dride/dride4K-Manufacturing/README.md

# dride4K-Manufacturing
dride4K-Manufacturing files , mechanical integration files and logistics
