dride/dride4K-Manufacturing/Hardware/BOM/Dride4K_BOM 301122.xlsx

Product SKU List |  |  | PCB List |  |  |  |  |  |  |  |  | Plastic List
front | 1076 |  | GPS HAT A | 1668 |  |  |  |  |  |  |  | 216DRI000 | Dride4K IR Cover | 3398
front + 4G | 621 |  | GPS Spacer | 1668 |  |  |  |  |  |  |  | 216DRI001 | Dride4K light guide | 5760
dual | 269 |  | LTE HAT A | 4332 |  |  |  |  |  |  |  | 216DRI002 | Dride4K Internal camera shell | 3510
dual + 4G | 177 |  | LTE Spacer | 4332 |  |  |  |  |  |  |  | 216DRI003 | Dride4K Camera Body | 5917
front + 128GB | 235 |  | Internal | 3585 |  |  |  |  |  |  |  | 216DRI004 | Dride4K Internal camera cover | 3482
front + 4G + 128 GB | 483 |  | External | 6000 |  |  |  |  |  |  |  | 216DRI005 | Dride4K Screw cover | 11779
Dual + 128GB | 88 |  | Radar | 6000 |  |  |  |  |  |  |  | 216DRI006 | Dride4K Button | 5901
Dual + 4G + 128GB | 3051 |  | Core | 2143 |  |  |  |  |  |  |  | 216DRI007 | Dride4K Braket | 5922
 |  |  | Extended Core | 3857 |  |  |  |  |  |  |  | 216DRI008 | Dride4K Button shell | 5910
LTE Type List |  |  |  |  |  |  |  |  |  |  |  | 216DRI010 | Dride4K Main Body SIM less | 1668
EC25-E | 2084
EC25-AF | 1957
EC25-AU | 219
EG25 | 72
Comment | Description | Footprint | LibRef | Manufacturer | Part Number | GPS HAT A | GPS Spacer | LTE HAT A | LTE Spacer | Internal | External | Radar | Core | Extended Core | front | front + 4G | dual | dual + 4G | front + 128GB | front + 4G + 128 GB | Dual + 128GB | Dual + 4G + 128GB | Total | Price/unit | Total Price
EC25-E | IoT/M2M-optimized LTE Cat4 Module 50Mbps/150Mbps UART/USB2.0/PCM/USIM/SDIO 850MHz/900MHz/1800MHz/1900MHz 3.8V Surface... | IC_XCVR_EC25EFA-512-STD/EC25EFAR02A09M4G | Quectel | EC25EFA-512-STD/EC25EFAR02A09M4G |  |  |  | 1 |  |  |  |  |  |  |  |  |  |  |  |  |  |  | 2084 | $28.9231
EC25-AF |  |  | Quectel |  |  |  |  | 0 |  |  |  |  |  |  |  |  |  |  |  |  |  |  | 1957
EC25-AU |  |  | Quectel |  |  |  |  | 0 |  |  |  |  |  |  |  |  |  |  |  |  |  |  | 219
EG25 |  |  | Quectel |  |  |  |  | 0 |  |  |  |  |  |  |  |  |  |  |  |  |  |  | 72
0402 orange led | Orange 0402 1 x 0.5 mm 120° | SML-LX0402SOC-TR | SML-LX0402SOC-TR | XINGLIGHT | XL-1005UOC |  |  |  |  |  |  |  | 1 | 1 | 1 | 1 | 1 | 1 | 1 | 1 | 1 | 1 | 6000 | $0.1846
0R | R5%_0R0_0402_63mW | R0402 | R_Ω_5%_0R0_0402_63mW |  |  | 4 |  | 5 |  | 0 | 1 | 1 | 16 | 16 | 22 | 23 | 22 | 23 | 22 | 23 | 22 | 23 | 136332 | $0.0002
0Ω 0603 | RES SMD 0 OHM JUMPER 1/10W 0603 Automotive AEC-Q200 | R0603 | R_Ω_1%_0R_0603_100mW |  |  | 1 |  | 1 |  |  |  |  |  |  | 1 | 1 | 1 | 1 | 1 | 1 | 1 | 1 | 6000 | $0.0006
1.0µF | Capacitor, X5R, ±5% | CAP_0402_C1005X04L | C_u_1.0uF_0402_X5R_5% |  |  |  |  |  |  |  |  |  | 3 | 3 | 3 | 3 | 3 | 3 | 3 | 3 | 3 | 3 | 18000 | $0.0023
1.2pF | 1.2pF Capacitor, NP0, ±2% | CAP_0201_C0603X03L_C | C_p_1p2F_0201_NP0_2% |  |  |  |  |  |  |  |  |  | 1 | 1 | 1 | 1 | 1 | 1 | 1 | 1 | 1 | 1 | 6000 | $0.0015
10µH | Chip inductor, IDC,min = 50 mA, ±20% | L_IND_1.6X0.8_C1608X06L | L_u_10µH_0603_20% |  |  |  |  |  |  |  |  |  | 1 | 1 | 1 | 1 | 1 | 1 | 1 | 1 | 1 | 1 | 6000 | $0.0040
100K 0402 | R1%_100k_0402_63mW | R0402 | R_K_100k_0402_63mW_1% |  |  | 7 |  | 10 |  | 0 | 1 |  | 10 | 10 | 18 | 21 | 18 | 21 | 18 | 21 | 18 | 21 | 120996 | $0.0003
100n_100V | C10%_100n_0603_100V_X7R | C0603 | C10%_100n_0603_100V_X7R |  |  | 0 |  |  |  |  |  |  |  |  | 0 | 0 | 0 | 0 | 0 | 0 | 0 | 0 | 0 | $0.0031
100n_16V | C10%_100n_0402_16V_X7R | C0402 | C10%_100n_0402_16V_X7R |  |  | 3 |  | 6 | 1 | 22 | 10 |  | 46 | 46 | 59 | 63 | 81 | 85 | 59 | 63 | 81 | 85 | 450198 | $0.0008
100pF | C20%_100pF_0402_10V | C0402 | C20%_100pF_0402_10V |  |  | 1 |  | 1 |  |  | 1 |  | 1 | 1 | 3 | 3 | 3 | 3 | 3 | 3 | 3 | 3 | 18000 | $0.0011
100R 0402 | R1%_100R_0402_63mW | R0402 | R_Ω_1%_100R_0402_63mW |  |  |  |  |  |  |  |  |  | 2 | 2 | 2 | 2 | 2 | 2 | 2 | 2 | 2 | 2 | 12000 | $0.0005
100uF | 100 µF ±20% 6.3V Ceramic Capacitor X5R 1206 (3216 Metric) | 1206-HIGH |  |  |  |  |  | 2 |  |  |  |  |  |  | 0 | 2 | 0 | 2 | 0 | 2 | 0 | 2 | 8664 | $0.0615
102pF 0402 | C10%_102pF_0402_50V | C0402 |  |  |  |  |  | 0 |  |  |  |  |  |  | 0 | 0 | 0 | 0 | 0 | 0 | 0 | 0 | 0 | $0.0011
104pF | C20%_104pF_0402_10V | C0402 | C20%_104pF_0402_10V |  |  |  |  |  |  |  |  |  | 1 | 1 | 1 | 1 | 1 | 1 | 1 | 1 | 1 | 1 | 6000 | $0.0008
10K 0402 | R1%_10k_0402_63mW | R0402 | R_K_1%_10k_0402_63mW |  |  | 3 |  | 4 |  | 2 |  | 3 | 10 | 10 | 16 | 17 | 18 | 19 | 16 | 17 | 18 | 19 | 107502 | $0.0003
10M 0402 | RES SMD 10M OHM 1% 1/16W 0402Automotive AEC-Q200 | R0402 | R_1%_10M_0402_63mW |  |  |  |  |  |  |  |  |  | 2 | 2 | 2 | 2 | 2 | 2 | 2 | 2 | 2 | 2 | 12000 | $0.0003
10n_50V | C10%_10n_0402_50V_X7R | C0402 | C10%_10n_0402_50V_X7R |  |  |  |  |  |  |  |  | 1 |  |  | 1 | 1 | 1 | 1 | 1 | 1 | 1 | 1 | 6000 | $0.0015
10nf | C10%_10n_0402_16V_X7R | C0402 | C10%_10n_0402_16V_X7R |  |  |  |  |  |  | 1 | 6 |  | 3 | 3 | 9 | 9 | 10 | 10 | 9 | 9 | 10 | 10 | 57585 | $0.0011
10p_50V | C5%_10p_0402_50V_NP0 | C0402 |  |  |  |  |  | 2 |  |  |  |  |  |  | 0 | 2 | 0 | 2 | 0 | 2 | 0 | 2 | 8664 | $0.0011
10u_10V | C20%_10u_0603_10V_X5R | C0603 | C20%_10u_0603_10V_X5R |  |  | 1 |  | 1 |  | 2 | 4 |  | 16 | 16 | 21 | 21 | 23 | 23 | 21 | 21 | 23 | 23 | 133170 | $0.0062
10uF 25V 0603 | CAP CER 10UF 25V X5R 0603 | C0603 |  |  |  | 2 |  | 2 |  |  |  |  |  |  | 2 | 2 | 2 | 2 | 2 | 2 | 2 | 2 | 12000
10u_6V3 | C20%_10u_0402_6V3_X5R | C0402 | C20%_10u_0402_6V3_X5R |  |  | 1 |  | 1 |  | 3 |  | 1 |  |  | 2 | 2 | 5 | 5 | 2 | 2 | 5 | 5 | 22755 | $0.0005
10uH_4020 | SWPA4020S100MT 10±20%V 1.60A | L20%_3u3_2020_5A0 |  | Sunlord | SWPA4020S100MT | 1 |  | 2 |  |  |  |  |  |  | 1 | 2 | 1 | 2 | 1 | 2 | 1 | 2 | 10332 | $0.0277
120R(Z) | FB25%_120R(Z)_0603_3A | 603 |  | FB25%_120R(Z)_0603_3A |  |  |  |  |  |  | 1 |  |  |  | 1 | 1 | 1 | 1 | 1 | 1 | 1 | 1 | 6000 | $0.0015
12pF | 12pF Capacitor, NP0, ±2% | CAP_0201_C0603X03L_C |  | C_p_12pF_V_NP0_2% |  |  |  |  |  |  |  |  | 4 | 4 | 4 | 4 | 4 | 4 | 4 | 4 | 4 | 4 | 24000 | $0.0015
12uH_4020 | SWPA4020S120MT 12±20%V 1.50A | L20%_3u3_2020_5A0 |  | Sunlord | SWPA4020S120MT | 1 |  | 1 |  |  |  |  |  |  | 1 | 1 | 1 | 1 | 1 | 1 | 1 | 1 | 6000 | $0.0277
13K | 13K | R0402 | R_K_13K_0402_63mW_1% |  |  |  |  |  |  | 0 |  |  |  |  | 0 | 0 | 0 | 0 | 0 | 0 | 0 | 0 | 0 | $0.0005
13K6 0402 | RES SMD 13.6K OHM 1% 1/10W 0402 | R0402 | R_K_1%_13K6_0402_0.1W |  |  | 1 |  | 1 |  |  |  |  |  |  | 1 | 1 | 1 | 1 | 1 | 1 | 1 | 1 | 6000 | $0.0005
150k | R1%_150k_0402_63mW | R0402 | R_K_1%_150k_0402_63mW |  |  |  |  |  |  |  |  |  | 1 | 1 | 1 | 1 | 1 | 1 | 1 | 1 | 1 | 1 | 6000 | $0.0005
15nH | High frequency chip inductor ±10% | L_IND_0402_C1005X04L | L_n_15nH_0402_10% |  |  |  |  |  |  |  |  |  | 1 | 1 | 1 | 1 | 1 | 1 | 1 | 1 | 1 | 1 | 6000 | $0.0015
15pF 0402 | CAP CER 15PF 50V C0G/NPO 0402 | C0402 | C5%_15pF_0402_50V |  |  |  |  |  |  |  |  |  | 2 | 2 | 2 | 2 | 2 | 2 | 2 | 2 | 2 | 2 | 12000 | $0.0011
17K65 0402 | RES SMD 17.65K OHM 1% 1/10W 0402 | R0402 |  |  |  |  |  | 1 |  |  |  |  |  |  | 0 | 1 | 0 | 1 | 0 | 1 | 0 | 1 | 4332 | $0.0005
18pF | CAP CER 18PF 50V C0G/NPO 0402 | C0402 | C5%_18pF_0402_50V |  |  |  |  |  |  |  |  |  | 4 | 4 | 4 | 4 | 4 | 4 | 4 | 4 | 4 | 4 | 24000 | $0.0011
1k | R1%_1k0_0402_63mW | R0402 | R_K_1%_1k0_0402_63mW |  |  | 2 |  | 2 |  |  | 6 |  | 3 | 3 | 11 | 11 | 11 | 11 | 11 | 11 | 11 | 11 | 66000 | $0.0003
1K5R 0402 | R1%_1K5R_0402_63mW | R0402 | R_K_1%_1K5R_0402_63mW |  |  |  |  |  |  |  | 2 |  |  |  | 2 | 2 | 2 | 2 | 2 | 2 | 2 | 2 | 12000 | $0.0003
1KR_100Mhz_0402 | 1 kOhms @ 100MHz 1 Signal Line Ferrite Bead 0402 (1005 Metric) 250mA 1.1Ohm BLM15HG102SN1D | C0402 | FB_1KR_100Mhz_0402_1 |  |  |  |  |  |  |  | 2 |  |  |  | 2 | 2 | 2 | 2 | 2 | 2 | 2 | 2 | 12000 | $0.0012
1M 0402 | RES SMD 1M OHM 1% 1/16W 0402 | R0402 | R_1%_1M_0402_63mW |  |  | 3 |  | 3 |  | 1 |  | 2 | 1 | 1 | 6 | 6 | 7 | 7 | 6 | 6 | 7 | 7 | 39585 | $0.0003
1M5R 0402 | RES SMD 1.5M OHM 1% 1/16W 0402 | R0402 | R_M_1M5R_0402_63mW |  |  |  |  |  |  |  |  | 1 |  |  | 1 | 1 | 1 | 1 | 1 | 1 | 1 | 1 | 6000 | $0.0005
1n_16V | C10%_1n_0402_16V_X7R | C0402 | C10%_1n_0402_16V_X7R |  |  |  |  |  |  |  |  |  | 3 | 3 | 3 | 3 | 3 | 3 | 3 | 3 | 3 | 3 | 18000 | $0.0011
1n_50V | C5%_1n_0402_50V_NP0 | C0402 | C5%_1n_0402_50V_NP0 |  |  |  |  |  |  |  | 1 | 4 |  |  | 5 | 5 | 5 | 5 | 5 | 5 | 5 | 5 | 30000 | $0.0011
1N5819 | 1N5819 | SOD123H14A | DIODE_SCHOTTKY | Jingdao Microelectronics | 1N5819 |  |  |  |  |  |  |  | 1 | 1 | 1 | 1 | 1 | 1 | 1 | 1 | 1 | 1 | 6000 | $0.0123
1pF | 1pF Capacitor, NP0, ±2% | CAP_0201_C0603X03L_C | C_p_1p0F_0201_NP0_2% |  |  |  |  |  |  |  |  |  | 1 | 1 | 1 | 1 | 1 | 1 | 1 | 1 | 1 | 1 | 6000 | $0.0015
1u_10V | C10%_1u_0402_10V_X5R | C0402 | C10%_1u_0402_10V_X5R |  |  | 2 | 1 | 2 |  | 4 | 2 | 2 | 7 | 7 | 14 | 13 | 18 | 17 | 14 | 13 | 18 | 17 | 94008 | $0.0023
1uH_2A | SMD INDUCTOR NR252012-1R0MC 1.0uH±20% DCR0.052-2.4A L2520 | L_1.0uH±20%_2.4A_L2520 | L_1uH_2.4A_20% | Sunlord | SWPA252012S 1R0 |  |  |  |  |  |  |  | 4 | 4 | 4 | 4 | 4 | 4 | 4 | 4 | 4 | 4 | 24000 | $0.0231
1W IR LED | 1W IR LED | IR_LED | D_IR_LED_1W | Guangzhou Juhong Optoelectronics | JH-1IRZ14G30-T3A-M850 |  |  |  |  | 1 |  |  |  |  | 0 | 0 | 1 | 1 | 0 | 0 | 1 | 1 | 3585 | $0.2308
2.2nH | 2.2nH High frequency chip inductor ±5% | L_IND_0201_C0603X03L_C | L_n_2n2H_0201_5% |  |  |  |  |  |  |  |  |  | 1 | 1 | 1 | 1 | 1 | 1 | 1 | 1 | 1 | 1 | 6000 | $0.0015
2.2uH@1A | SMD INDUCTOR NR252012-1R0MC 2.2uH±20% DCR0.052-2.4A L2520 | L2520 | L-L2520 | Sunlord | SWPA252010S 2R2 |  |  |  |  |  |  |  | 1 | 1 | 1 | 1 | 1 | 1 | 1 | 1 | 1 | 1 | 6000 | $0.0231
200K 0402 | RES SMD 200K OHM 1% 1/16W 0402 Automotive AEC-Q200 | R0402 | R_K_1%_200K_0402 |  |  |  |  |  |  |  |  |  | 1 | 1 | 1 | 1 | 1 | 1 | 1 | 1 | 1 | 1 | 6000 | $0.0005
20k | R1%_20k_0402_63mW | R0402 | R_K_1%_20K_0402_63mW |  |  |  |  |  |  |  |  | 1 |  |  | 1 | 1 | 1 | 1 | 1 | 1 | 1 | 1 | 6000 | $0.0005
220nF 0402 | C10%_220nF_0402_16V_X7R Ceramic Capacitor | C0402 | C10%_220nF_0402_16V_X7R |  |  |  |  |  |  |  |  |  | 1 | 1 | 1 | 1 | 1 | 1 | 1 | 1 | 1 | 1 | 6000 | $0.0011
22k | R1%_22k_0402_63mW | R0402 | R_K_1%_22K_0402_63mW |  |  |  |  |  |  |  |  | 1 |  |  | 1 | 1 | 1 | 1 | 1 | 1 | 1 | 1 | 6000 | $0.0005
22k6R 0402 | RES SMD 22.6K OHM 1% 1/16W 0402 | R0402 | R_K_22k6R_0402_63mW_1% |  |  | 1 |  | 1 |  |  |  |  |  |  | 1 | 1 | 1 | 1 | 1 | 1 | 1 | 1 | 6000 | $0.0005
22p_50V | C5%_22p_0402_50V_NP0 | C0402 | C5%_22p_0402_16V_NP0 |  |  |  |  |  |  |  |  |  | 1 | 1 | 1 | 1 | 1 | 1 | 1 | 1 | 1 | 1 | 6000 | $0.0011
22pF 0402 | CAP CER 22PF 50V NPO 0402 | C0402 | C5%_22pF_0402_50V |  |  | 2 |  | 3 |  |  |  |  |  |  | 2 | 3 | 2 | 3 | 2 | 3 | 2 | 3 | 16332 | $0.0011
22R | R1%_22R_0402_63mW | R0402 | R_Ω_1%_22R_0402_63mW |  |  | 1 |  | 1 |  |  |  |  | 1 | 1 | 2 | 2 | 2 | 2 | 2 | 2 | 2 | 2 | 12000 | $0.0003
22u_6V3 | C20%_22u_0402_6V3_X5R | C0402 | C20%_22u_0402_6V3_X5R |  |  | 2 |  | 3 |  |  |  |  |  |  | 2 | 3 | 2 | 3 | 2 | 3 | 2 | 3 | 16332 | $0.0308
22uF | C20%_22uF_0603_6v3 | C0603 | C20%_22uF_0603_6v3 |  |  |  |  |  |  |  | 1 |  | 5 | 5 | 6 | 6 | 6 | 6 | 6 | 6 | 6 | 6 | 36000 | $0.0123
22uF_0805 | C20%_22uF_0805_10V_X5R | C0805 | C20%_22uF_0805_10V_X5R |  |  | 1 |  | 1 |  |  |  |  |  |  | 1 | 1 | 1 | 1 | 1 | 1 | 1 | 1 | 6000 | $0.0123
240Ω 0402 | RES SMD 240 OHM 1% 1/16W 0402 Automotive AEC-Q200 | R0402 | R_Ω_1%_240R_0402_63mW |  |  |  |  |  |  |  |  |  | 5 | 5 | 5 | 5 | 5 | 5 | 5 | 5 | 5 | 5 | 30000 | $0.0003
2450AT18A100E | Ceramic Antenna, 2.45 GHZ, 2 W, -40 to 125 degC, 2-Pin SMD, RoHS, Tape and Reel | JT-2450AT18A100-2_V | CMP-2000-05167-1 | Johanson Technology | JT-2450AT18A100-2_V | 1 |  |  |  |  |  |  | 1 | 1 | 2 | 1 | 2 | 1 | 2 | 1 | 2 | 1 | 7668 | $0.1385
24M-20pF-10PPM | 24M-20pF-10PPM | CRYSTAL-4P-3225-H1A | CRY-24MHz-3225-SMD_2 |  |  |  |  |  |  |  |  |  | 1 | 1 | 1 | 1 | 1 | 1 | 1 | 1 | 1 | 1 | 6000 | $0.0769
2K 0402 | RES SMD 2K OHM 1% 1/16W 0402 Automotive AEC-Q200 | R0402 | R_K_1%_2K_0402_63mW |  |  |  |  |  |  |  |  |  | 8 | 8 | 8 | 8 | 8 | 8 | 8 | 8 | 8 | 8 | 48000 | $0.0003
2n2F 0402 | 2200 pF ±5% 50V Ceramic Capacitor X7R 0402 (1005 Metric) | C0402 | C5%_2200pF_2n2F_00402_50V_X7R |  |  |  |  |  |  |  |  |  | 1 | 1 | 1 | 1 | 1 | 1 | 1 | 1 | 1 | 1 | 6000 | $0.0011
2R2Ω 0603 | RES SMD 2.2 OHM 1% 1/10W 0603 Automotive AEC-Q200 | R0603 | R_Ω_1%_2R2_0603 |  |  | 1 |  | 1 |  |  |  |  |  |  | 1 | 1 | 1 | 1 | 1 | 1 | 1 | 1 | 6000 | $0.0006
2u2F | C20%_2u2F_0402_6v3 | C0402 | C20%_2u2F_0402_6v3 |  |  |  |  |  |  | 4 |  | 1 | 29 | 29 | 30 | 30 | 34 | 34 | 30 | 30 | 34 | 34 | 194340 | $0.0023
3.3F/2.7V | BCS2R7S335YS0802 | SCAP2-PT3_5-8X25H8A | CAPACITOR_POL | EDLCON | BCS2R7S335YS0802 | 2 |  | 2 |  |  |  |  |  |  | 2 | 2 | 2 | 2 | 2 | 2 | 2 | 2 | 12000 | $0.2308
3.3uH@0.7A DCR<0.1R | 3.3uH@0.7A DCR<0.1R | L3518 | INDUCTOR_Dup2 |  |  |  |  |  |  |  |  |  | 1 | 1 | 1 | 1 | 1 | 1 | 1 | 1 | 1 | 1 | 6000 | $0.0277
300R_100M_0402 | 300R_100M_0402 | 402 | FB_300R_100M_0402 |  |  |  |  |  |  |  |  |  | 2 | 2 | 2 | 2 | 2 | 2 | 2 | 2 | 2 | 2 | 12000 | $0.0025
30K 0402 | RES SMD 30K OHM 1% 1/16W 0402 | R0402 | R_K_1%_30K_0402_63mW |  |  |  |  |  |  |  | 2 |  |  |  | 2 | 2 | 2 | 2 | 2 | 2 | 2 | 2 | 12000 | $0.0003
32.000MHZ | 32 MHz ±20ppm Crystal 8pF 200 Ohms 4-SMD, No Lead | Crystal_32MHz_DFN160X120X45-4N | Y_ABM12-32.000MHZ-B2X-T3 | Abracon | ABM12-32.000MHZ-B2X-T3 |  |  |  |  |  |  |  | 1 | 1 | 1 | 1 | 1 | 1 | 1 | 1 | 1 | 1 | 6000 | $0.6154
32.768KHz | 32.768KHz | CRYSTAL-2P-3215-H0_85A | CRYSTAL2_0 | Abracon | ABS06-32.768KHZ-9-1-T |  |  |  |  |  |  |  | 1 | 1 | 1 | 1 | 1 | 1 | 1 | 1 | 1 | 1 | 6000 | $0.2231
32.768kHz | 32.768kHz Â±10ppm Crystal 9pF 90 kOhms 2-SMD, No Lead | XTAL_ABS06-32.768KHZ-9-1-T | ABS06-32.768KHZ-9-1-T | Abracon | ABS06-32.768KHZ-9-1-T |  |  |  |  |  |  |  | 1 | 1 | 1 | 1 | 1 | 1 | 1 | 1 | 1 | 1 | 6000 | $0.6154
330R | RES SMD 330 OHM 1% 1/10W 0402 | R0402 | R_Ω_1%_330R_0402_1/10W |  |  |  |  |  |  |  |  |  | 4 | 4 | 4 | 4 | 4 | 4 | 4 | 4 | 4 | 4 | 24000 | $0.0003
33pF 0402 | CAP 5% CER 33PF 50V NPO 0402 | C0402 | C5%_33pF_0402_50V |  |  |  |  | 5 | 3 |  | 2 |  |  |  | 2 | 10 | 2 | 10 | 2 | 10 | 2 | 10 | 46656 | $0.0011
33R | R1%_33R_0402_63mW | R0402 | R_Ω_33R_0402_63mW_1%, R_Ω_1%_33R_0402_63mW |  |  | 3 |  | 1 |  |  |  |  | 5 | 5 | 8 | 6 | 8 | 6 | 8 | 6 | 8 | 6 | 39336 | $0.0003
37.4M-16pF-10PPM |  | CRYSTAL-4P-3225-H1A | CRYSTAL-4_0 |  |  |  |  |  |  |  |  |  | 1 | 1 | 1 | 1 | 1 | 1 | 1 | 1 | 1 | 1 | 6000 | $0.0769
3A | F_F_3A_1206_P | 1206 | F_F_3A_1206_P |  |  | 1 |  | 1 |  |  |  |  |  |  | 1 | 1 | 1 | 1 | 1 | 1 | 1 | 1 | 6000 | $0.0462
4.7nH | 4.7nH High frequency chip inductor ±5% | L_IND_0201_C0603X03L_C | L_n_4n7H_0201_5% |  |  |  |  |  |  |  |  |  | 1 | 1 | 1 | 1 | 1 | 1 | 1 | 1 | 1 | 1 | 6000 | $0.0015
470nF | C10%_470n_0402_16V_X5R | C0402 | C10%_470n_0402_16V_X5R |  |  |  |  |  |  |  |  |  | 3 | 3 | 3 | 3 | 3 | 3 | 3 | 3 | 3 | 3 | 18000 | $0.0011
470R | 470R | R0402 | R_Ω_470R_0402_63mW_1% |  |  | 1 |  |  |  |  |  |  |  |  | 1 | 0 | 1 | 0 | 1 | 0 | 1 | 0 | 1668 | $0.0006
473pF | C10%_473pF_0402_6v3 | C0402 | C10%_473pF_0402_6v3 |  |  |  |  |  |  | 0 |  |  |  |  | 0 | 0 | 0 | 0 | 0 | 0 | 0 | 0 | 0 | $0.0011
47K 0402 | RES SMD 47K OHM 1% 1/16W 0402 Automotive AEC-Q200 | R0402 | R_K_47K_0402_1% |  |  |  |  |  |  |  |  | 1 | 1 | 1 | 2 | 2 | 2 | 2 | 2 | 2 | 2 | 2 | 12000 | $0.0003
47nF | 47nF | C0402 | C10%_47n_0402_16V_X7R |  |  |  |  |  |  | 1 | 2 |  | 1 | 1 | 3 | 3 | 4 | 4 | 3 | 3 | 4 | 4 | 21585 | $0.0011
4k7 | R1%_4k7_0402_63mW | R0402 | R_K_1%_4k7_0402_63mW |  |  |  |  |  |  | 2 |  |  |  |  | 0 | 0 | 2 | 2 | 0 | 0 | 2 | 2 | 7170 | $0.0005
4p7F 0402 | CAP CER 4.7PF 50V C0G/NPO 0402 | C0402 | C5%_4p7F_0402_50V |  |  |  |  |  |  |  |  |  | 1 | 1 | 1 | 1 | 1 | 1 | 1 | 1 | 1 | 1 | 6000 | $0.0011
4pF_0402 | C_p_4pF_0402_25V_C0G/NP0_+-0.25pF | C0402 | C_p_4pF_0402_25V_C0G/NP0_+-0.25pF |  |  |  |  |  |  |  |  | 1 |  |  | 1 | 1 | 1 | 1 | 1 | 1 | 1 | 1 | 6000 | $0.0011
4u7F | C20%_4u7F_0402_6v3, [NoValue] | C0402 | C20%_4u7F_0402_6v3, C20%_4u7_0402_6.3V_X5R |  |  |  |  |  |  | 5 | 16 |  | 7 | 7 | 23 | 23 | 28 | 28 | 23 | 23 | 28 | 28 | 155925 | $0.0031
4u7F 0603 | C20%_4u7F_0603_10V | C0603 | C20%_4u7F_0603_10V |  |  |  |  |  |  |  |  |  | 4 | 4 | 4 | 4 | 4 | 4 | 4 | 4 | 4 | 4 | 24000 | $0.0042
4u7F 0603 25V | CAP CER 4.7UF 25V X5R 0603 | C0603 | C20%_4u7F_0603_25V |  |  | 2 |  | 3 |  |  |  |  |  |  | 2 | 3 | 2 | 3 | 2 | 3 | 2 | 3 | 16332 | $0.0046
5.1K | R_K_5K1_0402_1%_63mW | R0402 | R_K_5K1_0402_1%_63mW |  |  | 2 |  | 2 |  |  |  |  |  |  | 2 | 2 | 2 | 2 | 2 | 2 | 2 | 2 | 12000 | $0.0003
500R@100MHz | Murata DLW5BTN501SQ2L | L25%_500R@100MHz_4A_Common_Mode_Choke | L25%_500R@100MHz_4A_Common_Mode_Choke | Murata | DLW5BTM501SQ2L | 1 |  | 1 |  |  |  |  |  |  | 1 | 1 | 1 | 1 | 1 | 1 | 1 | 1 | 6000 | $0.4462
51k | R1%_51k_0603_100mW | R0603 |  |  |  |  |  | 1 |  |  |  |  |  |  | 0 | 1 | 0 | 1 | 0 | 1 | 0 | 1 | 4332 | $0.0006
51K 0402 | RES SMD 51K OHM 1% 1/16W 0402 Automotive AEC-Q200 | R0402 | R_K_1%_51K_0402_63mW |  |  |  |  |  |  |  |  |  | 2 | 2 | 2 | 2 | 2 | 2 | 2 | 2 | 2 | 2 | 12000 | $0.0003
680R | R1%_680R_0402_63mW | R0402 | R_Ω_1%_680R_0402_63mW |  |  |  |  |  |  |  |  | 0 |  |  | 0 | 0 | 0 | 0 | 0 | 0 | 0 | 0 | 0 | $0.0005
820pF | 820pF Capacitor, NP0, ±2% | CAP_0201_C0603X03L_C | C_p_820pF_0201_NP0_2% |  |  |  |  |  |  |  |  |  | 1 | 1 | 1 | 1 | 1 | 1 | 1 | 1 | 1 | 1 | 6000 | $0.0015
8k2R 0402 | R_K_1%_8k2R_0402_63mW | R0402 | R_K_1%_8k2R_0402_63mW |  |  |  |  |  |  |  |  |  | 1 | 1 | 1 | 1 | 1 | 1 | 1 | 1 | 1 | 1 | 6000 | $0.0005
AP6256 | The AMPAK Technology® AP6256 is a fully Wi-Fi and Bluetooth functionalities module with seamless roaming capabilities and advance security, also it could interact with different vendors’ 802.11a/b/g/n/ac 1x1 Access Points with SISO standard and can accomplish up to speed of 433.3Mbps with single stream in 802.11ac to connect the wireless LAN. | AP6256_QFN44-12X12H1_6A | IC_AP6256 | AMPAK Technology | AP6256 |  |  |  |  |  |  |  | 1 | 1 | 1 | 1 | 1 | 1 | 1 | 1 | 1 | 1 | 6000 | $5.8462
AXP2101 | Power Management IC | AXP_2101_QFN40-PT0_4-5X5H0_8A | IC_AXP2101_0 | Allwinner | AXP_2101 |  |  |  |  |  |  |  | 1 | 1 | 1 | 1 | 1 | 1 | 1 | 1 | 1 | 1 | 6000 | $0.0000
BISS0001 | Micro Power PIR Motion Detector IC | BISS0001 | IC_BISS0001 | Silvan Chip Electronics Tech |  |  |  |  |  |  |  | 1 |  |  | 1 | 1 | 1 | 1 | 1 | 1 | 1 | 1 | 6000 | $0.0538
BLM1.5AG121SN1 | BLM1.5AG121SN1 | 402 | BLM1.5AG121SN1 |  |  | 1 |  |  |  |  |  |  |  |  | 1 | 0 | 1 | 0 | 1 | 0 | 1 | 0 | 1668 | $0.0031
BPW17N | BPW17N | XDCR_BPW17N | BPW17N | Vishay | BPW17N |  |  |  |  | 1 |  |  |  |  | 0 | 0 | 1 | 1 | 0 | 0 | 1 | 1 | 3585 | $0.2769
CMEJ-0415-42-P | CMEJ-0415-42-P | MIC_CMEJ_0415_42_P_SIDE | MIC_CMEJ-0415-42-P | CUI Devices | CMEJ-0415-42-P |  |  |  |  |  | 1 |  |  |  | 1 | 1 | 1 | 1 | 1 | 1 | 1 | 1 | 6000 | $0.2462
CS8302 | CHIP IC MSOP-8 ROHS | MSOP-8_TSSOP-8_SOT505-2 | IC_CS8302 | ICST | ICS8302-01 |  |  |  |  |  | 1 |  |  |  | 1 | 1 | 1 | 1 | 1 | 1 | 1 | 1 | 6000 | $0.2769
D_1615-T0.6 BGR | RGB LED model:XL-1615RGB-RF Name: 1615-T0.6 BGR | LED-1_6X1_5H0_6A | LED_XL-1615RGB-RF | XINGLIGHT | 'XL-1615RGB-RF |  |  |  |  |  |  |  | 1 | 1 | 1 | 1 | 1 | 1 | 1 | 1 | 1 | 1 | 6000 | $0.0092
DA380 | MEMS digital output motion sensor low-power high performance 3-axes “DSC-XYZ” accelerometer | LGA-10_SOP10-PT05-MMA7660FC-H1A | IC_DA380 | MiraMEMS | G-SENSOR DA380B6 LGA10 |  |  |  |  |  |  |  | 1 | 1 | 1 | 1 | 1 | 1 | 1 | 1 | 1 | 1 | 6000 | $0.3538
DDR3-FBGA96 | Commercial Grade : 0℃~95℃ . DDR3(L) 2Gb SDRAM | DDR3_FBGA96C80P10X13 | IC_DDR3-FBGA96_SNB6416S16NS23 | Nanya | NT5CC128M16JR-EK |  |  |  |  |  |  |  | 2 | 2 | 2 | 2 | 2 | 2 | 2 | 2 | 2 | 2 | 12000 | $1.7846
DTC114EE | BJT, NPN, Single, 50V, 0.1A, wb, SC-70, 47K | SOT-416H1_15A | BJT_NPN_wr_x1_0 | ROHM | DTC114EE | 2 |  | 3 |  |  |  |  | 3 | 3 | 5 | 6 | 5 | 6 | 5 | 6 | 5 | 6 | 34332 | $0.0538
ESD | GG0402050R3C2P | C0402 | ESD9B5VL, 1_1.5KE100A_Dup3 | Kyocera AVX | GG0402050R3C2P | 8 |  | 8 |  | 0 | 4 |  | 1 | 1 | 13 | 13 | 13 | 13 | 13 | 13 | 13 | 13 | 78000 | $0.0123
ESD_12V | Diode TVS Single Bi-Directional 12V 130W 0402 2-Pin Surface Mount T/R | C0402 | GG0402126R042P | Kyocera AVX | GG0402126R042P | 1 |  | 1 |  |  |  |  |  |  | 1 | 1 | 1 | 1 | 1 | 1 | 1 | 1 | 6000 | $0.0462
ETST00327000JE | ETST00327000JE | CRYSTAL-2P-3215-H0_85A | CRYSTAL_XCOL-3_0 | HOSONIC | ETST00327000JE |  |  |  |  |  |  |  | 1 | 1 | 1 | 1 | 1 | 1 | 1 | 1 | 1 | 1 | 6000 | $0.2231
FH35C-41S-0.3SHW(99) | FFC FPC Connectors Horizontal Mounting Angle Gray 0.3 mm - Pitch 41 Positions | FH35C-41S-0.3SHW(99) | FH35C-41S-0.3SHW(99) | hirose | FH35C-41S-0.3SHW(99) |  |  |  |  | 1 | 1 |  | 2 | 2 | 3 | 3 | 4 | 4 | 3 | 3 | 4 | 4 | 21585 | $0.2308
FSUSB30UMX | FSUSB30 Series DPDT 4.3 V 480 Mbps SMT Hi Speed USB 2.0 Switch - MSOP-10 | UMLP-10 | FSUSB30UMX | ON Semiconductor | FSUSB30UMX |  |  |  |  |  |  |  | 1 | 1 | 1 | 1 | 1 | 1 | 1 | 1 | 1 | 1 | 6000 | $0.2923
GPIO KEY/UBOOT | GPIO KEY/UBOOT | SW4-SKQG-5_2X5_2H1_5A | SW_PUSH_0 |  |  |  |  |  |  |  |  |  | 1 | 1 | 1 | 1 | 1 | 1 | 1 | 1 | 1 | 1 | 6000 | $0.0123
GPS_ANT | 1575MHz GPS Ultra-Compact Ceramic Chip Antenna | ANT_GPS-1575AT44A0010 | ANT_GPS_1575AT44A0010 | Johanson Technology |  | 0 |  | 0 |  |  |  |  |  |  | 0 | 0 | 0 | 0 | 0 | 0 | 0 | 0 | 0 | $1.0000
HXQK-TYPE-C-3.1 | CQ-USB-C16PSMT01 | USB_TYPEC_7_6X8_94H3_26A | USB_MINI_SOCKET_3 | nova microwave | CQ-USB-C16PSMT01 | 1 |  | 1 |  |  |  |  |  |  | 1 | 1 | 1 | 1 | 1 | 1 | 1 | 1 | 6000 | $0.0092
IMX415 | Sony image sensor IMX415 | IMX415_&_lens_&_mount | IC_IMX415 | SONY | IMX415-AAQR-C |  |  |  |  |  | 1 |  |  |  | 1 | 1 | 1 | 1 | 1 | 1 | 1 | 1 | 6000 | $6.6923
JAE_NANOSIM_SF72S006VBAR2500 | SF72 series, nano-SIM card connector, normail open type, 6 connector | X1 | X_JAE_NANOSIM_SF72S006VBAR2500 | X_JAE_NANOSIM_SF72S006VBAR2500 |  |  |  |  | 1 |  |  |  |  |  | 0 | 1 | 0 | 1 | 0 | 1 | 0 | 1 | 4332 | $0.4615
KLM4G1FETE-B041 | 4 GB eMMC Ver5.1 compatible . HS400- 153FBGA | EMMC_BGA153FBGA | MCP-153FBGA | Samsung Semiconductor | KLM4G1FETE-B041 |  |  |  |  |  |  |  | 1 | 0 | 1 | 1 | 1 | 1 | 0 | 0 | 0 | 0 | 2143 | $2.2308
KLMDG4UCTA-B041 | 128 GB eMMC Ver5.1 compatible | EMMC_BGA169-PT0_5-12X16H1A | MCP-BGA169_5 | Samsung Semiconductor | KLMDG4UCTA-B041 |  |  |  |  |  |  |  | 0 | 1 |  |  |  |  | 1 | 1 | 1 | 1 | 3857 | $18.4615
LP3220SAB5F | LP3220S is a 1.5MHz constant frequency current mode PWM step-down converter | SOT23-5 | IC_LP3220SAB5F | LPSemi | LP3220SAB5F |  |  |  |  |  |  |  | 1 | 1 | 1 | 1 | 1 | 1 | 1 | 1 | 1 | 1 | 6000 | $0.0769
ME6216A12 | ME6216A12XG voltage regulator | ME-6216_SOT23-3 | IC_ME6216A12XG | microne | ME6216A12 |  |  |  |  | 1 |  |  |  |  | 0 | 0 | 1 | 1 | 0 | 0 | 1 | 1 | 3585 | $0.0308
MIC5219BM5 | MIC5219BM5 | IC_MIC5219BM5_SOT23-5 | IC_MIC5219BM5 |  |  |  |  |  |  | 0 |  |  |  |  | 0 | 0 | 0 | 0 | 0 | 0 | 0 | 0 | 0 | $0.9231
MICROSD/TF_SLOT | MICROSD/TF_SLOT | TF_CARDH1_7A | SDMMC SLOT_0 | XKB Connectivity |  |  | 1 |  | 1 |  |  |  |  |  | 1 | 1 | 1 | 1 | 1 | 1 | 1 | 1 | 6000 | $0.0769
ML621 | ML621 | CSE | BAT_6 | FDK | ML621 | 2 |  | 1 |  |  |  |  |  |  | 2 | 1 | 2 | 1 | 2 | 1 | 2 | 1 | 7668 | $0.3231
MX6208 | MX6208 Motor driver power supply voltage range:4.5V-15V 100mAContinuous current SOP8 | MX6208 | IC_MX6208 | Mixic | MX6208 |  |  |  |  | 1 |  |  |  |  | 0 | 0 | 1 | 1 | 0 | 0 | 1 | 1 | 3585 | $0.0338
nRF52833_QFN40 | Multi-protocol Bluetooth Low Energy, IEEE 802.15.4, ANT and 2.4GHz proprietary system-on-chip | QFN40P500X500X50_HS-41N | IC_nRF52833_QDAA | Nordic Semiconductor | nRF52833-QDAA |  |  |  |  |  |  |  | 1 | 1 | 1 | 1 | 1 | 1 | 1 | 1 | 1 | 1 | 6000 | $2.3846
PCF8563 | The PCF8563 is a CMOS1 Real-Time Clock (RTC) and calendar | MSOP-8_TSSOP-8_SOT505-2 | IC_PCF8563 | NXP Semiconductors | PCF8563 |  |  |  |  |  |  |  | 1 | 1 | 1 | 1 | 1 | 1 | 1 | 1 | 1 | 1 | 6000 | $0.5077
RB520S30 | RB520S30 Schottky Barrier Diode SOD-532 Average rectified forward current 200mA Peak forward surge current 1A | SOD-523 | D_SCHOTTKY_RB520S30 | WillSemi | RB520S30 | 1 |  | 1 |  |  |  |  | 2 | 2 | 3 | 3 | 3 | 3 | 3 | 3 | 3 | 3 | 18000 | $0.0154
RB521C30 | Schottky Barrier Diode/SCHOTTKY BARRIER DIODE 200MA | D0402 | DIODE SCHOTTKY | WillSemi | RB521C30 | 1 |  | 1 |  |  |  |  |  |  | 1 | 1 | 1 | 1 | 1 | 1 | 1 | 1 | 6000 | $0.0538
RFI Cage Clip | RFI Cage Clip | RFI_CLIP_1X4_4 | 681-0072A-1 |  |  |  |  |  |  |  |  |  | 6 | 6 | 6 | 6 | 6 | 6 | 6 | 6 | 6 | 6 | 36000 | $0.0000
20279-001 E - 05 | I-PEX U.FL connector 20279-001 E - 05 |  |  | I-PEX | 20279-001 E - 05 |  |  | 2 |  |  |  |  |  |  | 0 | 2 | 0 | 2 | 0 | 2 | 0 | 2 | 8664 | $0.6154
RTL8188EUS | RTL8188EUS | RTL8188EUS | RTL8188EUS |  |  | 1 |  |  |  |  |  |  |  |  | 1 | 0 | 1 | 0 | 1 | 0 | 1 | 0 | 1668 | $1.6154
SC223A | SC223A | SC223A | IC_SC223A | SmartSens | SC223A |  |  |  |  | 1 |  |  |  |  | 0 | 0 | 1 | 1 | 0 | 0 | 1 | 1 | 3585 | $1.8462
SGDBF-05-08P_H30 | SGDBM-FEMALE connector board to board 0.5 pitch 8Pins 3.0mm height | X_SGDBF-05-08P_H30 | X_SGDBF-05-08P_H30 | SGDCON | SGDBF-05-08P_H30 |  |  |  |  |  |  | 2 |  |  | 2 | 2 | 2 | 2 | 2 | 2 | 2 | 2 | 12000 | $0.2154
SGDBM-05-08P_H10 | SGDBM-MALE connector board to board 0.5 pitch 8Pins 1.0mm height | X_SGDBM-05_08PIN_H10 | X_SGDBM-05_008P_H10 | SGDCON | SGDBM-05-08P_H10 |  |  |  |  |  | 2 |  |  |  | 2 | 2 | 2 | 2 | 2 | 2 | 2 | 2 | 12000 | $0.2154
SKG09BL | GPS Module | SKG09BL_SOP18 | SKG09BL | SKYLAB | SKG09BL | 1 |  |  |  |  |  |  |  |  | 1 | 0 | 1 | 0 | 1 | 0 | 1 | 0 | 1668 | $3.3846
SLG59M301VTR | 4A Load Switch, 7.8mOhm, N-MOSFET | SLG59M301VTR | IC_SLG59M301VTR | Silego Technology | SLG59M301VTR |  |  |  |  | 1 |  |  | 1 | 1 | 1 | 1 | 2 | 2 | 1 | 1 | 2 | 2 | 9585 | $0.3846
SRK1101 | SRK1101 | SRK1101A | IC_SRK1101 | SGR Semiconductors Inc | SRK1101A |  |  |  |  |  |  | 1 |  |  | 1 | 1 | 1 | 1 | 1 | 1 | 1 | 1 | 6000 | $2.0000
SY8120B1 | AN_SY8120B1 DCDC step down convertor | SOT95P280X145-6N | Silergy | Silergy | AN_SY8120B1 | 2 |  | 3 |  |  |  |  |  |  | 2 | 3 | 2 | 3 | 2 | 3 | 2 | 3 | 16332 | $0.1154
V536 | V536 is a high-performance, low-power Mobile Camera SoC | V536_BGA412P50B1400_1400 | IC_V536 | Allwinner | Allwinner V536 |  |  |  |  |  |  |  | 1 | 1 | 1 | 1 | 1 | 1 | 1 | 1 | 1 | 1 | 6000 | $0.0000
White LED | White LED | 402 | D_white_0402 |  |  |  |  |  |  |  |  | 0 |  |  | 0 | 0 | 0 | 0 | 0 | 0 | 0 | 0 | 0 | $0.1200
WPM2087 | Single P-Channel, -20V, -4.3A, Power MOSFET | SOT-23 | Q_PMOS | WillSemi | WPM2087 |  |  |  |  |  |  |  | 4 | 4 | 4 | 4 | 4 | 4 | 4 | 4 | 4 | 4 | 24000 | $0.0538
X_SGDBF-05-60P-H45 | SGDBM- FE-MALE connector board to board 0.5 pitch 60Pins 4.5mm height | X_SGDBF-05-60P-H45 | X_SGDBF-05-60P-H45 | SGDCONN | SGDBF-05-60P-H45 |  |  |  |  |  |  |  | 1 | 1 | 1 | 1 | 1 | 1 | 1 | 1 | 1 | 1 | 6000 | $0.5538
X_SGDBM-05-60P-H20 | SGDBM- MALE connector board to board 0.5 pitch 60Pins 2.0mm height | X_SGDBM-05-60P-H20 | X_SGDBM-05-60P-H20 | SGDCONN | SGDBM-05-60P-H20 | 1 |  | 1 |  |  |  |  |  |  | 1 | 1 | 1 | 1 | 1 | 1 | 1 | 1 | 6000 | $0.5538
XC7021 | XC7021 | XC7021 | IC_XC7021 | X - Chip | XC7021 |  |  |  |  | 1 |  |  |  |  | 0 | 0 | 1 | 1 | 0 | 0 | 1 | 1 | 3585 | $2.0308
External lens mount | External lens mount |  |  |  |  |  |  |  |  |  | 1 |  |  |  | 1 | 1 | 1 | 1 | 1 | 1 | 1 | 1 | 6000
Internal lens mount | Internal lens mount |  |  |  |  |  |  |  |  | 1 |  |  |  |  | 0 | 0 | 1 | 1 | 0 | 0 | 1 | 1 | 3585
33R 1/2W | R_Ω_33R_0805_500mW_1% |  |  |  |  |  |  |  |  | 3 |  |  |  |  | 0 | 0 | 3 | 3 | 0 | 0 | 3 | 3 | 10755
