dride/dride4K-Manufacturing/Hardware/electronics manufacturing files/Final/Dride4K_HAT_GPS_manufacturing_files_211222/Bill of Materials/Bill of Materials-dride4k-hat-GPS_0.5(Manufacturing).xlsx

Comment | Description | Designator | Quantity
0R | R5%_0R0_0402_63mW | R11, R12, R13, R16 | 4
0Ω 0603 | R_Ω_1%_0R_0603_100mW | R25 | 1
100K 0402 | R1%_100k_0402_63mW | R10, R35, R38, R43, R59, R60, R61 | 7
100n_16V | C10%_100n_0402_16V_X7R | C5, C8, C31, C41 | 4
100pF | C20%_100pF_0402_10V | C11 | 1
10K 0402 | R1%_10k_0402_63mW | R36, R58, R20 | 3
10u_6V3 | C20%_10u_0402_6V3_X5R | C9 | 1
10u_10V | C20%_10uF_0603_10V | C2 | 1
10uF 25V 0603 | CAP CER 10UF 25V X5R 0603 | C26, C27 | 2
10uH_4020 | SWPA4020S100MT 10±20%V 1.60A | L6 | 1
12uH_4020 | SWPA4020S120MT 12±20%V 1.50A | L4 | 1
13K6 0402 | RES SMD 13.6K OHM 1% 1/10W 0402 | R45 | 1
1k | R1%_1k0_0402_63mW | R27, R56 | 2
1M 0402 | RES SMD 1M OHM 1% 1/16W 0402 | R47, R50, RC2 | 3
1u_10V | C10%_1u_0402_10V_X5R | C3, C4, C30 | 3
22k6R 0402 | RES SMD 22.6K OHM 1% 1/16W 0402 | R62 | 1
22pF 0402 | CAP CER 22PF 50V NPO 0402 | C32, C42 | 2
22R | R1%_22R_0402_63mW | R57 | 1
22u_6V3 | C20%_22u_0402_6V3_X5R | C33, C43 | 2
22uF_0805 | C20%_22uF_0805_10V_X5R | C1 | 1
2450AT18A100E | Ceramic Antenna, 2.45 GHZ, 2 W, -40 to 125 degC, 2-Pin SMD, RoHS, Tape and Reel | E1 | 1
2R2Ω 0603 | RES SMD 2.2 OHM 1% 1/10W 0603 Automotive AEC-Q200 | RC1 | 1
3.3F/2.7V | BCS2R7S335YS0802 | EC1, EC2 | 2
33R | R1%_33R_0402_63mW | R7, R8, R9 | 3
3A | F_F_3A_1206_P | F1 | 1
470R |  | R1 | 1
4u7F 0603 25V | CAP CER 4.7UF 25V X5R 0603 | C34, C44 | 2
5.1K | R_K_5K1_0402_1%_63mW | R6, R51 | 2
500R@100MHz | Murata DLW5BTM501SQ2L - with white markings for direction | L2 | 1
BLM1.5AG121SN1 |  | FB1 | 1
DTC114EE | BJT, NPN, Single, 50V, 0.1A, wb, SC-70, 47K | Q1, Q6 | 2
ESD | GG0402050R3C2P | ESD1, ESD2, ESD3, ESD4, ESD5, ESD6, ESD7, ESD8 | 8
ESD_12V | GG0402126R042P | ESD9 | 1
AN06 GPS active antenna | AN06 GPS active antenna | Card2 | 1
GPS_CARD_SPACER |  | Card1 | 1
HXQK-TYPE-C-3.1 | CQ-USB-C16PSMT01 | USB1 | 1
ML621 |  | BAT1, BAT2 | 2
RB520S30 | WillSemi | D2, D7 | 2
RB521C30 | WillSemi | D8 | 1
RFI Cage Clip | RFI Cage Clip | RFCL1, RFCL2 | 2
RTL8188EUS |  | IC5 | 1
SKG09BL | GPS Module | IC2 | 1
SY8120B1 | AN_SY8120B1 DCDC step down convertor | IC1, IC7 | 2
X_SGDBM-05-60P-H20 | SGDBM- MALE connector board to board 0.5 pitch 60Pins 2.0mm height | X6 | 1
