dride/dride4K-Manufacturing/Hardware/electronics manufacturing files/Final/Dride4K_HAT_LTE_manufacturing_files_211222/Bill of Materials/Bill of Materials-dride4k-hat-lte_05(Production).xlsx

Comment | Description | Designator | Quantity
Silergy SY8120B1 | AN_SY8120B1 DCDC step down convertor | IC1, IC6, IC7 | 3
0R | R5%_0R0_0402_63mW | R1, R16, R17, R20, R21 | 5
0Ω 0603 | RES SMD 0 OHM JUMPER 1/10W 0603 Automotive AEC-Q200 | R25 | 1
100K 0402 | R1%_100k_0402_63mW | R35, R37, R38, R43, R52, R53, R54, R59, R60, R61 | 10
100n_16V | C10%_100n_0402_16V_X7R | C4, C8, C18, C23, C31, C35, C41 | 7
100pF_0402 | CAP, CERM, 100 pF, 50 V, +/- 5%, X7R, 0402 | C11 | 1
100uF | 100 µF ±20% 6.3V Ceramic Capacitor X5R 1206 (3216 Metric) | C16, C21 | 2
10K 0402 | R1%_10k_0402_63mW | R7, R36, R58, R65 | 4
10p_50V | C5%_10p_0402_50V_NP0 | C20, C25 | 2
10u_6V3 | C20%_10u_0402_6V3_X5R | C9 | 1
10uF 10V | C20%_10uF_0603_10V | C2 | 1
10uF 25V 0603 | CAP CER 10UF 25V X5R 0603 | C26, C27 | 2
10uH_4020 | Sunlord SWPA4020S100MT , 10±20%V , 1.60A | L5, L6 | 2
12uH_4020 | Sunlord SWPA4020S120MT , 12±20%V , 1.50A | L4 | 1
13K6 0402 | RES SMD 13.6K OHM 1% 1/10W 0402 | R45 | 1
17K65 0402 | RES SMD 17.65K OHM 1% 1/10W 0402 | R55 | 1
1k | R1%_1k0_0402_63mW | R27, R56 | 2
1M 0402 | RES SMD 1M OHM 1% 1/16W 0402 | R47, R50, RC2 | 3
1u_10V | C10%_1u_0402_10V_X5R | C3, C17, C22, C30 | 4
22k6R 0402 | RES SMD 22.6K OHM 1% 1/16W 0402 | R62 | 1
22pF 0402 | CAP CER 22PF 50V NPO 0402 | C32, C38, C42 | 3
22R | R1%_22R_0402_63mW | R57 | 1
22u_6V3 | C20%_22u_0402_6V3_X5R | C33, C39, C43 | 3
22uF_0805 | C20%_22uF_0805_10V_X5R | C1 | 1
2R2Ω 0603 | RES SMD 2.2 OHM 1% 1/10W 0603 Automotive AEC-Q200 | RC1 | 1
3.3F/2.7V | BCS2R7S335YS0802 | EC1, EC2 | 2
33pF_50V | Cap Ceramic 33pF 50V C0G 5% SMD 0402 125C T/R | C5, C6, C7, C19, C24 | 5
33R | R1%_33R_0402_63mW | R9 | 1
3A | F_F_3A_1206_P | F1 | 1
4u7F 0603 25V | CAP CER 4.7UF 25V X5R 0603 | C34, C40, C44 | 3
5.1K | R_K_5K1_0402_1%_63mW | R6, R51 | 2
500R@100MHz | Murata DLW5BTM501SQ2L - with white markings for direction | L2 | 1
51k | R1%_51k_0603_100mW | R13 | 1
LTE_card_spacer_rev04 | LTE_card_spacer_rev04 | Card1 | 1
DTC114EE | BJT, NPN, Single, 50V, 0.1A, wb, SC-70, 47K | Q1, Q2, Q6 | 3
EC25EFA-512-STD/EC25EFAR02A09M4G | IoT/M2M-optimized LTE Cat4 Module 50Mbps/150Mbps UART/USB2.0/PCM/USIM/SDIO 850MHz/900MHz/1800MHz/1900MHz 3.8V Surface... | IC2 | 1
ESD | GG0402050R3C2P | ESD1, ESD2, ESD3, ESD4, ESD5, ESD6, ESD7, ESD8 | 8
ESD_12V | GG0402126R042P | ESD9 | 1
AN06 GPS active antenna | GPS antenna module | Card2 | 1
HXQK-TYPE-C-3.1 | CQ-USB-C16PSMT01 | USB1 | 1
ML621 |  | BAT1 | 1
RB520S30 | RB520S30 Schottky Barrier Diode SOD-532 Average rectified forward current 200mA Peak forward surge current 1A | D2, D7 | 2
RB521C30 | Schottky Barrier Diode/SCHOTTKY BARRIER DIODE 200MA | D8 | 1
RFI Cage Clip | RFI Cage Clip | RFCL1, RFCL2 | 2
I-PEX 20279-001 E - 05 | I-PEX U.FL connector 20279-001 E - 05 | X4, X5 | 2
SGDBM-05-60P-H20 | SGDBM- MALE connector board to board 0.5 pitch 60Pins 2.0mm height | X6 | 1
