dride/dride4K-Manufacturing/Mechanics/batch500_version 0.7/Button shell assy.SLDASM

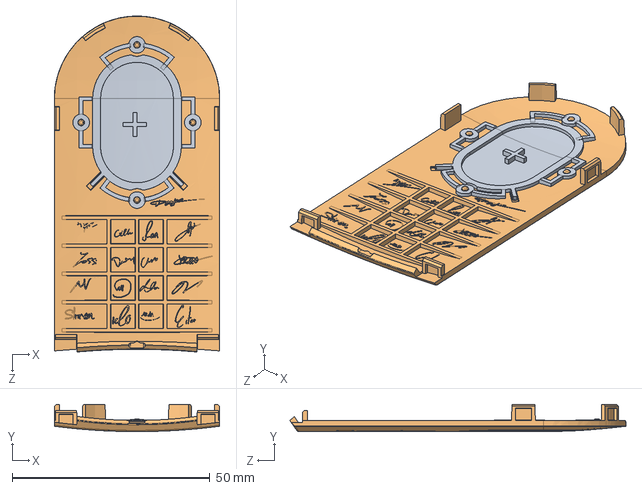
[picture p3: CAD file, 2022-12-13]
Mechanics/batch500_version 0.7/Button shell assy.SLDASM
41.8 x 6.88 x 84.9 mm
216DRI006-Dride4K Button
216DRI008-Dride4K Button shell
