dride/dride4K-Manufacturing/Mechanics/batch500_version 0.7/internal_camera_assy.STEP

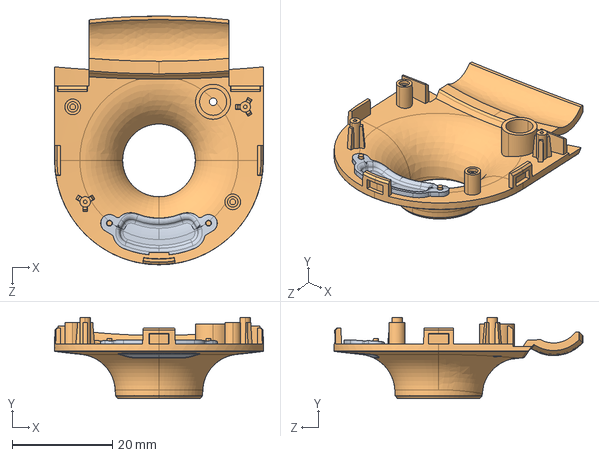
[picture p4: CAD file, 2022-12-13]
Mechanics/batch500_version 0.7/internal_camera_assy.STEP
41.8 x 16.2 x 49.7 mm
