dride/dride4K-Manufacturing/Mechanics/batch500_version 0.7/Main body assy.SLDASM

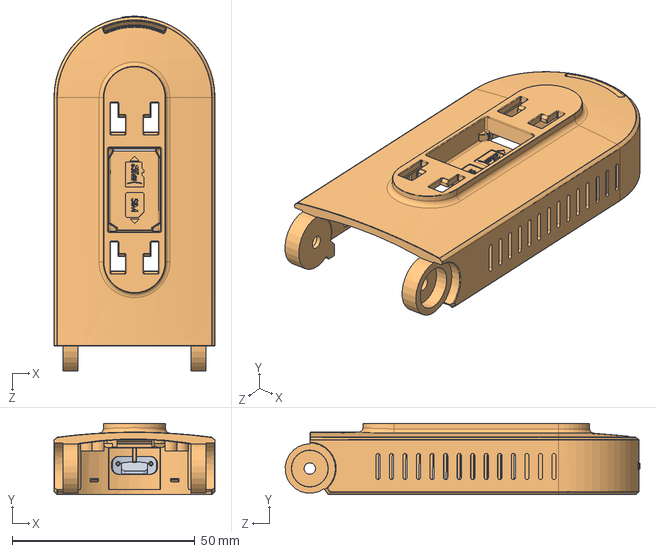
[picture p5: CAD file, 2022-12-13]
Mechanics/batch500_version 0.7/Main body assy.SLDASM
44.0 x 19.5 x 96.9 mm
216DRI001-Dride4K Light guide
216DRI009-Dride4K Main Body
