dride/dride4K-Manufacturing/Mechanics/batch500_version 0.7/Parts/STEP/216DRI001-Dride4K Light guide.STEP

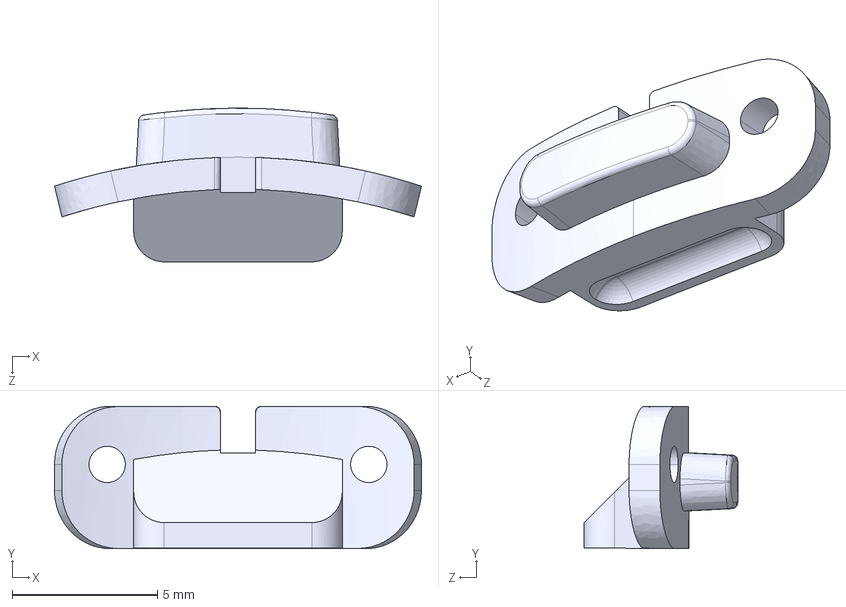
[picture p6: CAD file, 2022-12-12]
Mechanics/batch500_version 0.7/Parts/STEP/216DRI001-Dride4K Light guide.STEP
12.6 x 4.90 x 5.29 mm
