dride/dride4K-Manufacturing/Mechanics/batch500_version 0.7/Parts/STEP/216DRI002-Dride4K Internal camera shell.STEP

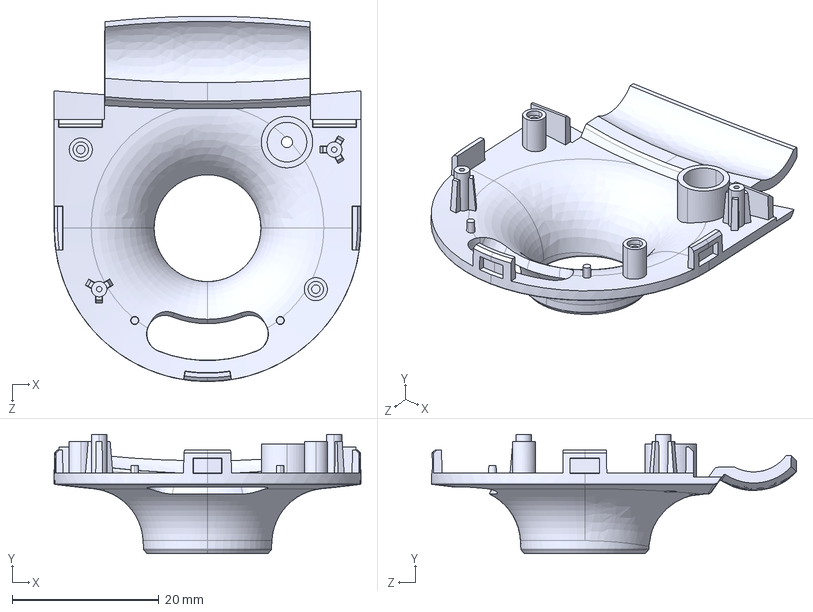
[picture p7: CAD file, 2022-12-12]
Mechanics/batch500_version 0.7/Parts/STEP/216DRI002-Dride4K Internal camera shell.STEP
41.8 x 16.2 x 49.7 mm
