dride/dride4K-Manufacturing/Mechanics/batch500_version 0.7/Parts/STEP/216DRI003-Dride4K Camera Body.STEP

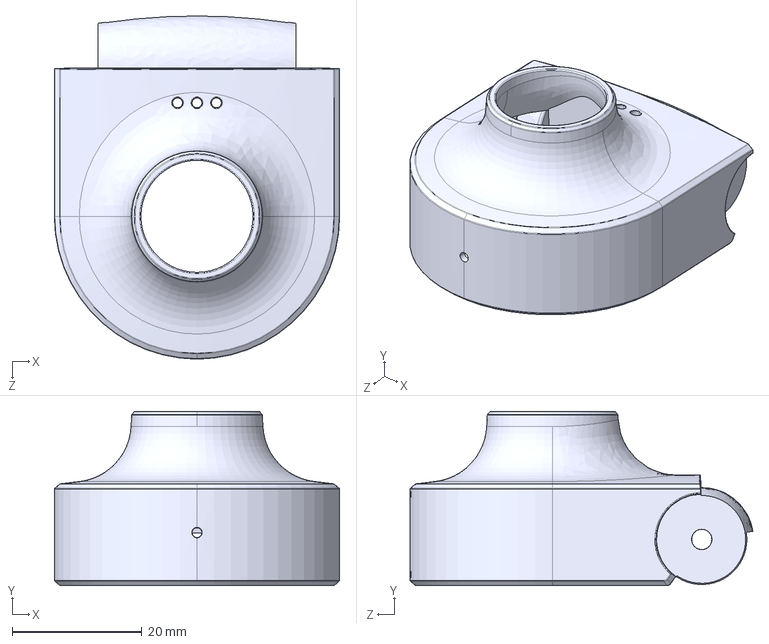
[picture p8: CAD file, 2022-12-12]
Mechanics/batch500_version 0.7/Parts/STEP/216DRI003-Dride4K Camera Body.STEP
44.0 x 26.9 x 52.9 mm
