dride/dride4K-Manufacturing/Mechanics/batch500_version 0.7/Parts/STEP/216DRI006-Dride4K Button.STEP

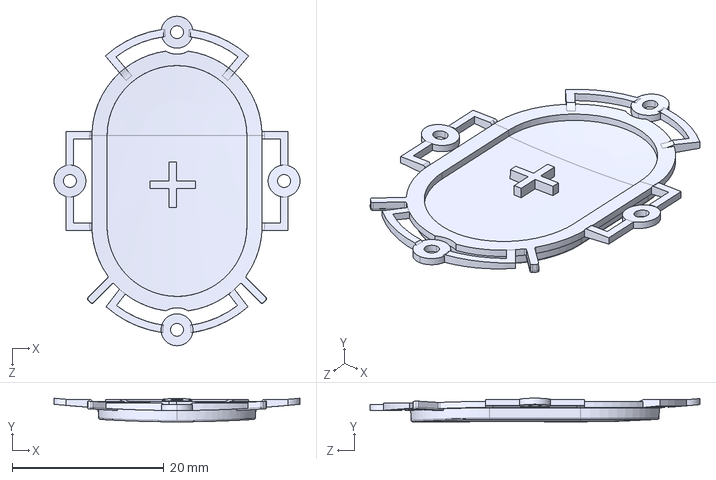
[picture p9: CAD file, 2022-12-12]
Mechanics/batch500_version 0.7/Parts/STEP/216DRI006-Dride4K Button.STEP
32.4 x 3.12 x 43.4 mm
