dride/dride4K-Manufacturing/Mechanics/batch500_version 0.7/Parts/STEP/216DRI000-Dride4K IR cover.STEP

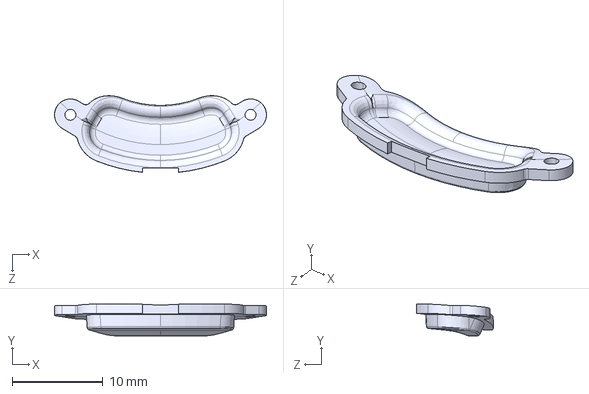
[picture p10: CAD file, 2022-12-12]
Mechanics/batch500_version 0.7/Parts/STEP/216DRI000-Dride4K IR cover.STEP
23.3 x 3.49 x 8.43 mm
