dride/dride4K-Manufacturing/Mechanics/batch500_version 0.7/Parts/STEP/216DRI004-Dride4K Internal camera cover.STEP

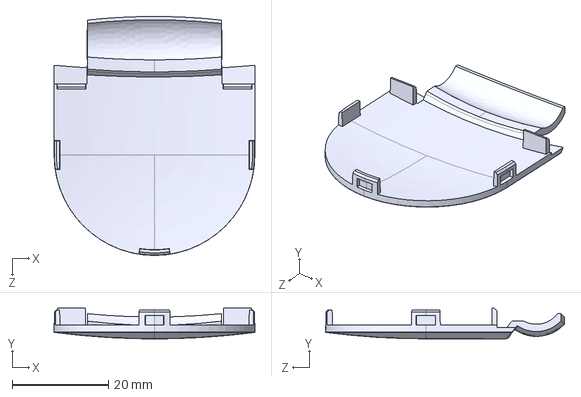
[picture p11: CAD file, 2022-12-12]
Mechanics/batch500_version 0.7/Parts/STEP/216DRI004-Dride4K Internal camera cover.STEP
41.8 x 6.40 x 49.7 mm
