dride/dride4K-Manufacturing/Mechanics/batch500_version 0.7/Parts/STEP/216DRI007-Dride4K Braket.STEP

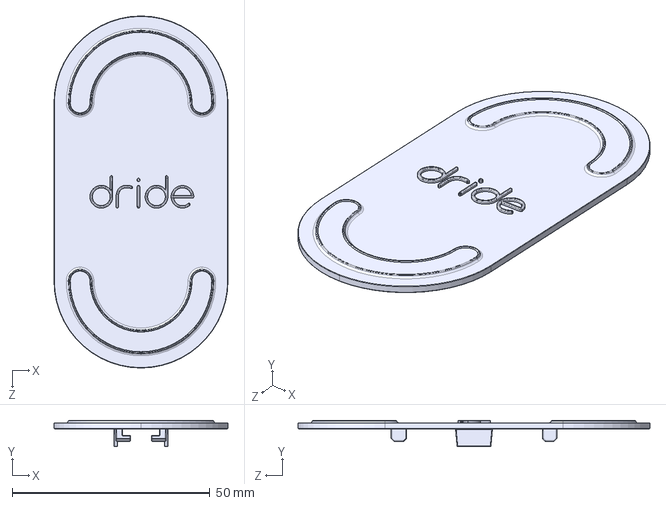
[picture p12: CAD file, 2022-12-12]
Mechanics/batch500_version 0.7/Parts/STEP/216DRI007-Dride4K Braket.STEP
44.0 x 6.60 x 89.0 mm
