dride/dride4K-Manufacturing/(list of files, cad)

Other CAD files:
Mechanics/batch500_version 0.7/Parts/STEP/216DRI010-Dride4K Main Body SIM less.STEP
Mechanics/batch500_version 0.7/Dor_full_assembly/Dride4K_Main_Body_216DRI009.SLDPRT
Mechanics/batch500_version 0.7/Dor_full_assembly/Dride4K_Button_216DRI006.SLDPRT
Mechanics/batch500_version 0.7/Dor_full_assembly/Dride4K_Button_Shell_216DRI008.SLDPRT
Mechanics/batch500_version 0.7/Dor_full_assembly/Dride4K_EXT_CAM_rev04_180822.SLDPRT
Mechanics/batch500_version 0.7/Dor_full_assembly/Dride4K_Camera_Body_216DRI003.SLDPRT
Mechanics/batch500_version 0.7/Dor_full_assembly/Dride4K_Internal_Camera_Shell_216DRI002.SLDPRT
Mechanics/batch500_version 0.7/Dor_full_assembly/int_cam_06_alon.SLDPRT
Mechanics/batch500_version 0.7/EMI_tape.SLDDRW
Mechanics/batch500_version 0.7/Main body assy.SLDPRT
Mechanics/batch500_version 0.7/Parts/SLDPRT/216DRI000-Dride4K IR cover.SLDPRT
Mechanics/batch500_version 0.7/Parts/SLDPRT/216DRI001-Dride4K Light guide.SLDPRT
Mechanics/batch500_version 0.7/Parts/SLDPRT/216DRI002-Dride4K Internal camera shell.SLDPRT
Mechanics/batch500_version 0.7/Parts/SLDPRT/216DRI003-Dride4K Camera Body.SLDPRT
Mechanics/batch500_version 0.7/Parts/SLDPRT/216DRI004-Dride4K Internal camera cover.SLDPRT
Mechanics/batch500_version 0.7/Parts/SLDPRT/216DRI005-Dride4K Screw cover.SLDPRT
Mechanics/batch500_version 0.7/Parts/SLDPRT/216DRI006-Dride4K Button.SLDPRT
Mechanics/batch500_version 0.7/Parts/SLDPRT/216DRI007-Dride4K Braket.SLDPRT
Mechanics/batch500_version 0.7/Parts/STEP/216DRI005-Dride4K Screw cover.STEP
Mechanics/batch500_version 0.7/Screws/BN 20173 - DELTA PT pan head screws with Torx plus STP39A0250120-1.SLDPRT
Mechanics/batch500_version 0.7/Screws/M3 Nyloc Nut-1.SLDPRT
Mechanics/batch500_version 0.7/Screws/Screw STS KN1039 2x5 - T6 STP39A0200050-1.SLDPRT
Mechanics/batch500_version 0.7/Screws/Stainless Steel Socket Head Screw M3x12-1.SLDPRT
Mechanics/batch500_version 0.7/internal_camera_assy.SLDASM
Mechanics/batch500_version 0.7/internal_camera_assy.SLDPRT
