dride/dride4K-Manufacturing/Hardware/electronics manufacturing files/Final/Dride4K_HAT_GPS_manufacturing_files_211222/BOTTOM.png

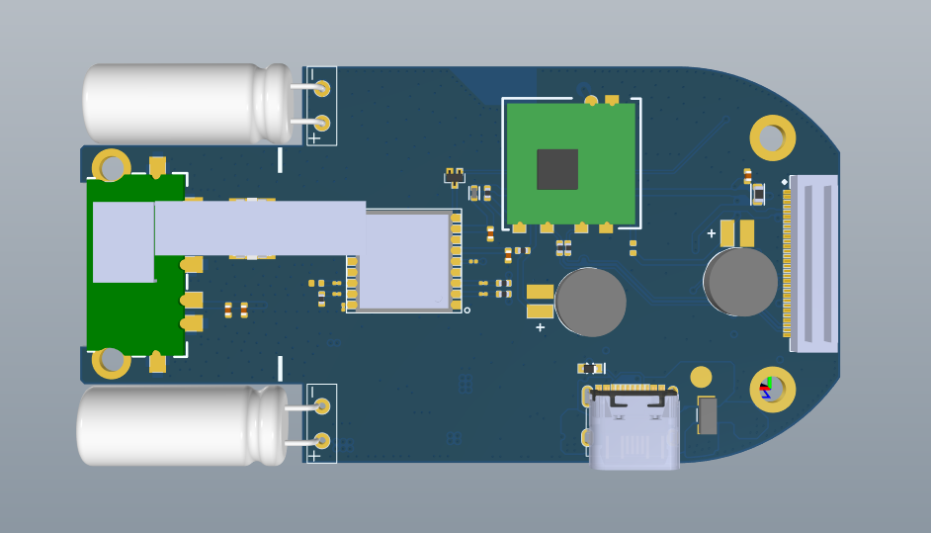
Hardware/electronics manufacturing files/Final/Dride4K_HAT_GPS_manufacturing_files_211222/BOTTOM.png
