dride/dride4K-Manufacturing/(threads)

Thread 2 (2023-02-14):

Bill of Materials-Dride4K_rev10(Extended memory)

applieder, 2023-02-14:
memory not memmory @DorDavid95

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

picture from the extended core BOM - this cant be empty @sbinyamin
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

picture from the final manufacturing quantities list
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
