dride/dride4K-Manufacturing/(commit log)

2022-12-12 initial commit and latest BOM files
    [Dride4K_BOM 301122.xlsx, 副本BOM 301122(1) Daisy dride 12.1 quotation need to fix.xlsx]
2022-12-12 insert solid files final BOM qty+prices
    [1.SLDPRT, 1.STEP, 10.SLDPRT, 10.STEP, 12.SLDPRT, 12.STEP, 15.STEP, 2.SLDPRT]
2022-12-13 made sub assys and imported screws
    [1.SLDPRT, 1.STEP, 10.SLDPRT, 10.STEP, 12.SLDPRT, 12.STEP, 15.STEP, 2.SLDPRT]
2022-12-14 assembly progress
2022-12-14 manufacturing zip files for board spacers(LTE & GPS) and EXT_CAM_rev05
2022-12-19 gerber compare and more
    [dride4K_06.GBL, dride4K_06.GBO, dride4K_06.GBP, dride4K_06.GBS, dride4K_06.GKO, dride4K_06.GTL, dride4K_06.GTO, dride4K_06.GTP]
2022-12-19 EMI tapes
    [BN 20173 - DELTA PT pan head screws with Torx plus STP39A0250120-1.SLDPRT, EMI_tape.SLDDRW, M3 Nyloc Nut-1.SLDPRT, Screw STS KN1039 2x5 - T6 STP39A0200050-1.SLDPRT, Stainless Steel Socket Head Screw M3x12-1.SLDPRT]
2022-12-19 added final manufacture files to radar and GPS spacer
2022-12-20 final final
    [Bill of Materials-dride4k-hat-GPS_0.5(Manufacturing).xlsx, Bill of Materials-dride4k-hat-lte_05(Production).xlsx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]
2022-12-21 fixed gerber files for HAT LTE & NC drill for HAT GPS
    [Bill of Materials-dride4k-hat-GPS_0.5(Manufacturing).xlsx, Bill of Materials-dride4k-hat-lte_05(Production).xlsx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]
